saeedniko/LumiCtrl/README.md

# LumiCtrl
Hardware and firmware design for controlling LED strips using an ESP32 microcontroller. Includes circuit design, PCB layout, and software for lighting effects and control.
