saeedniko/LumiCtrl/Hardware/LumiCtrl_rev11/Bottom.pdf

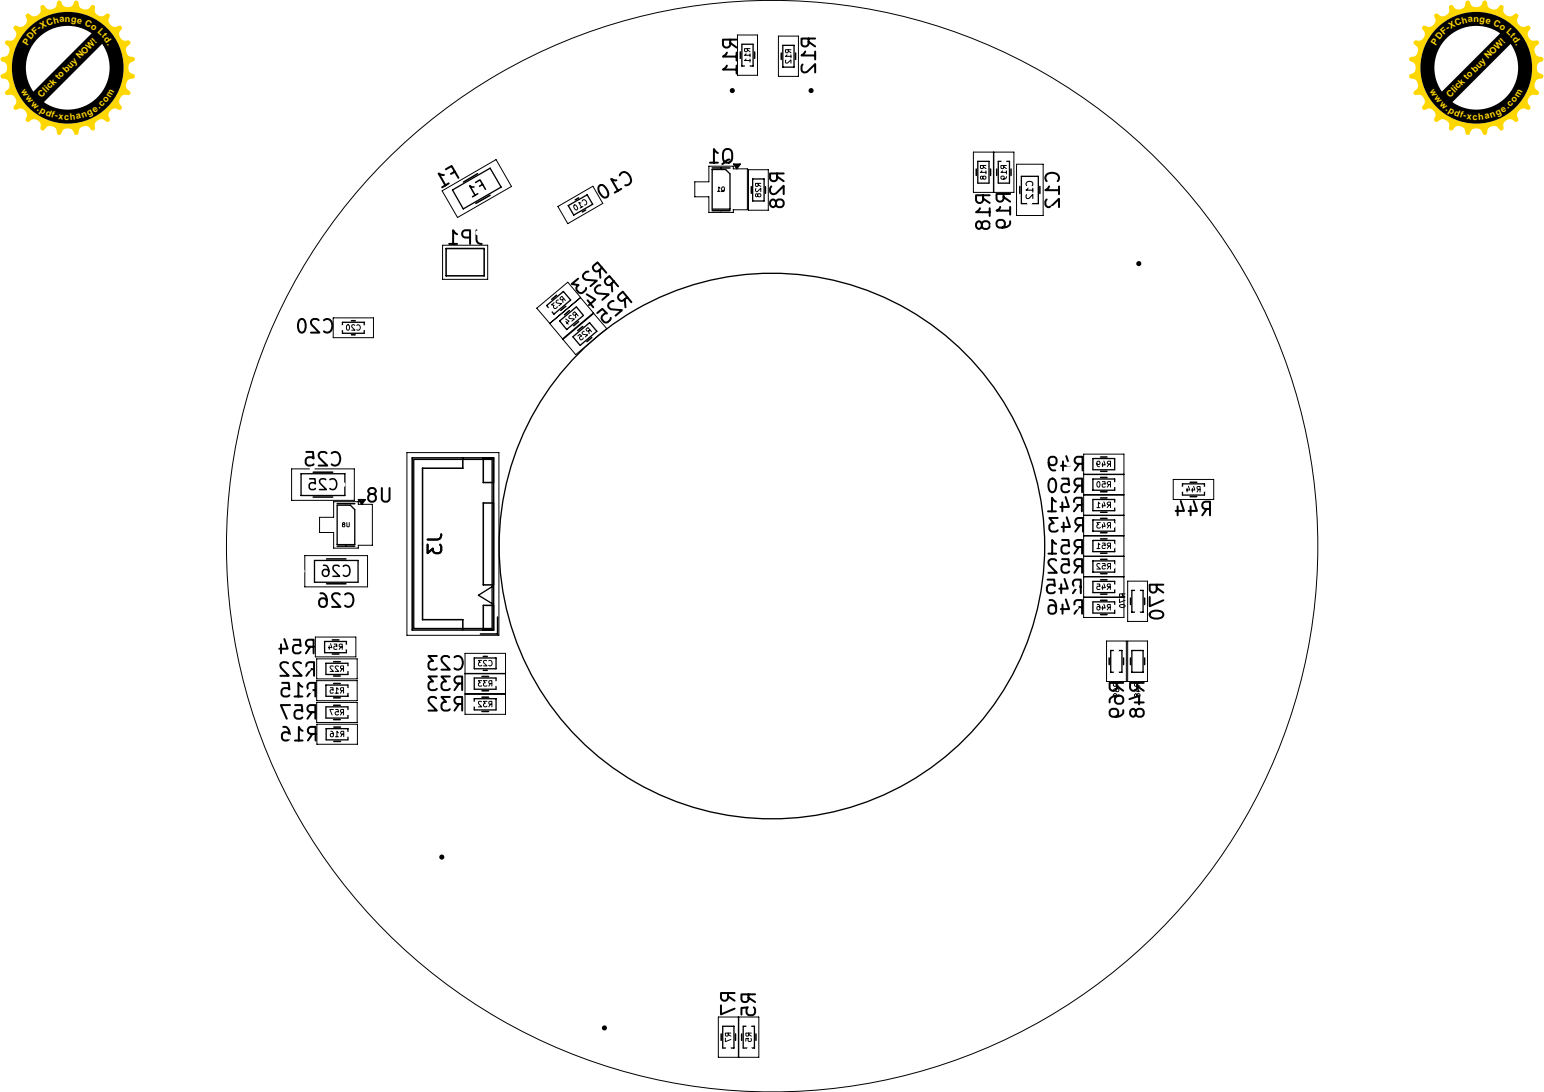
[picture p1: page 1]

PDF-XChange Co Ltd.

Click to buy NOW!

www.pdf-xchange.com

www.pdf-xchange.com (https://www.pdf-xchange.com/buy-now)
