saeedniko/LumiCtrl/Hardware/LumiCtrl_rev11/Schematic.pdf

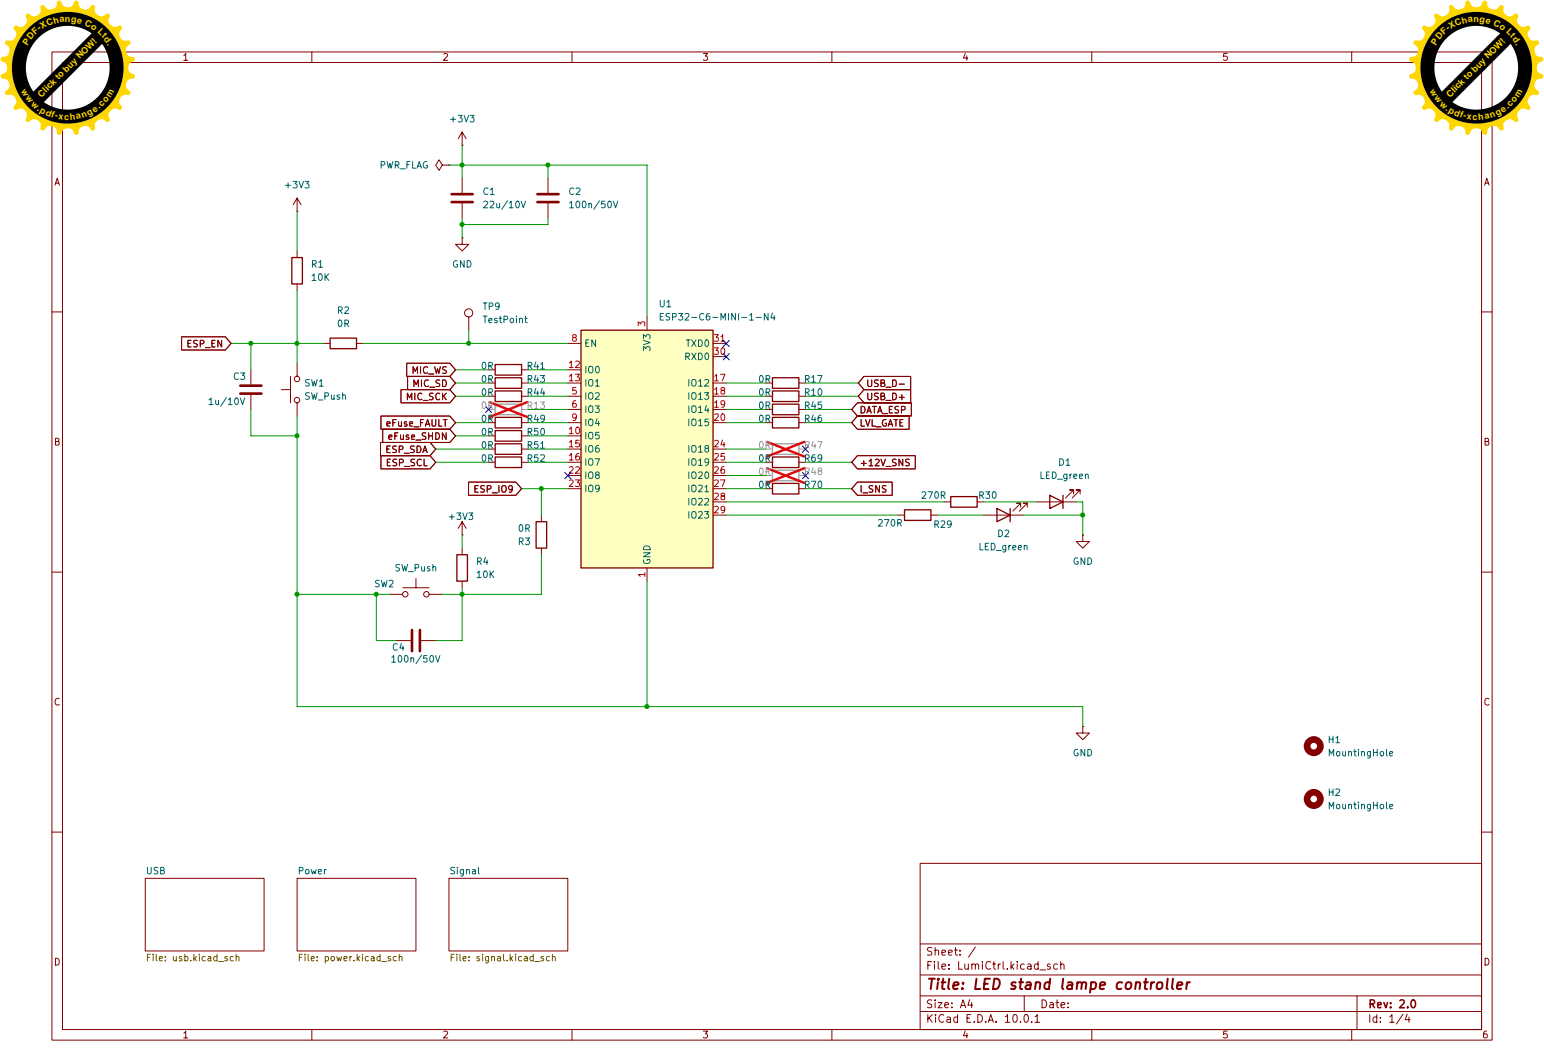
[picture p2: page 1]

PDF-XChange Co Ltd.

Click to buy NOW!

www.pdf-xchange.com

www.pdf-xchange.com (https://www.pdf-xchange.com/buy-now)

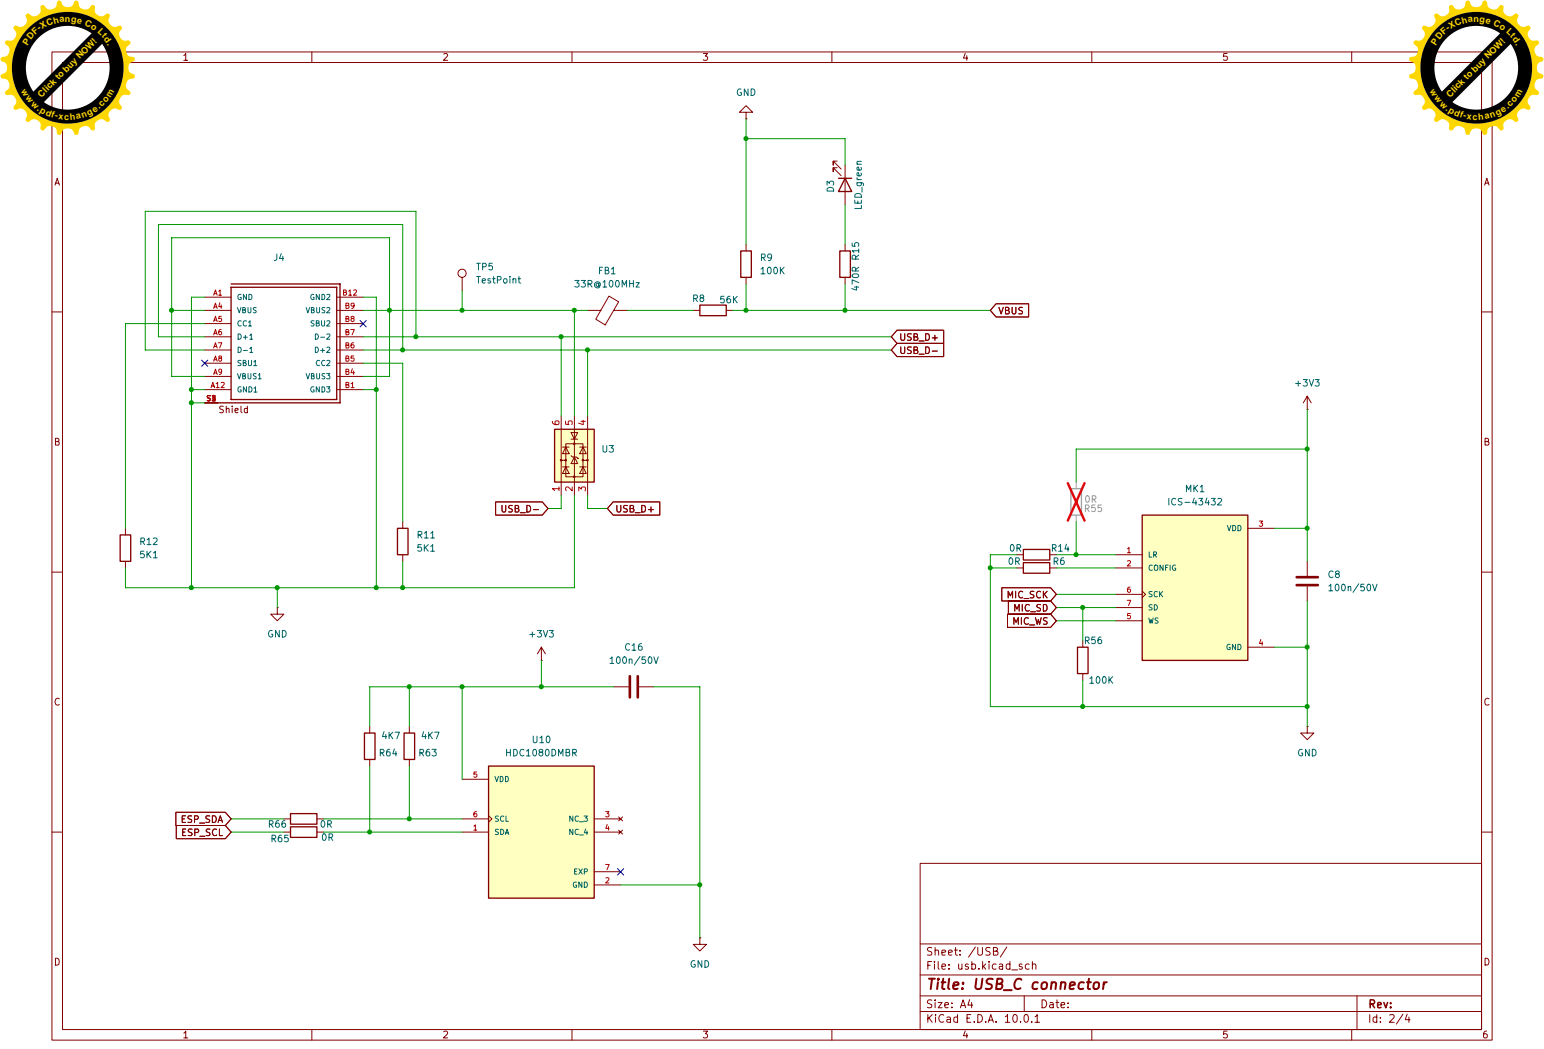
[picture p3: page 2]

Click to buy NOW!

www.pdf-xchange.com

www.pdf-xchange.com (https://www.pdf-xchange.com/buy-now)

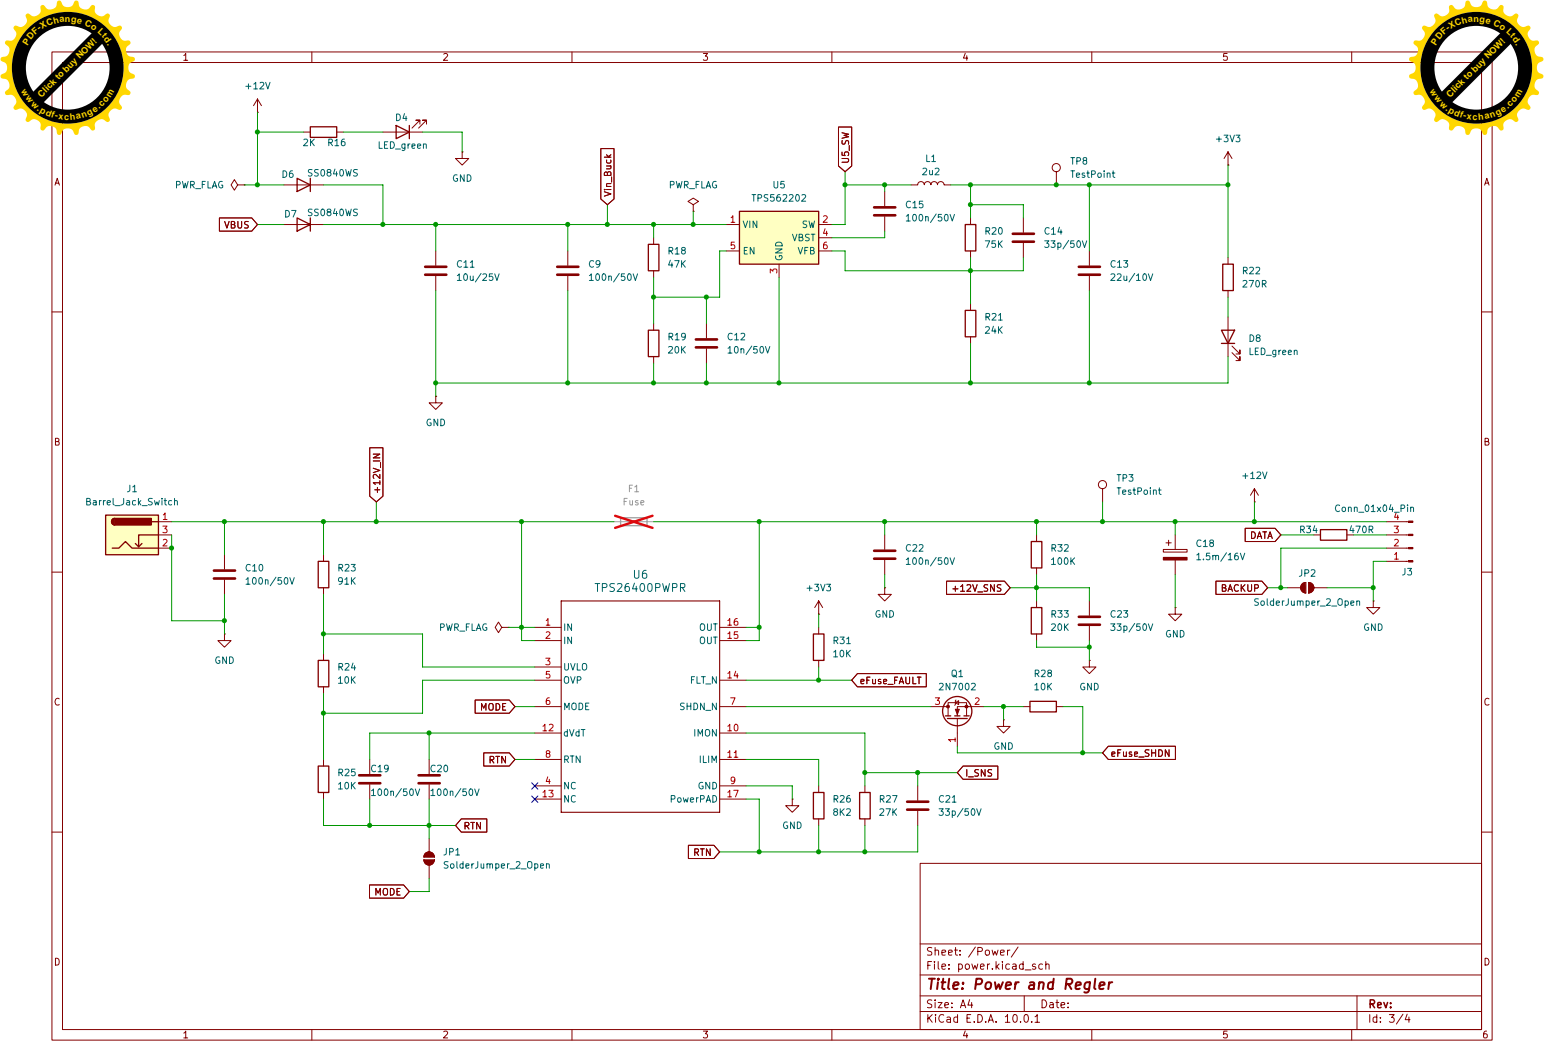
[picture p4: page 3]

Click to buy NOW!

www.pdf-xchange.com

www.pdf-xchange.com (https://www.pdf-xchange.com/buy-now)

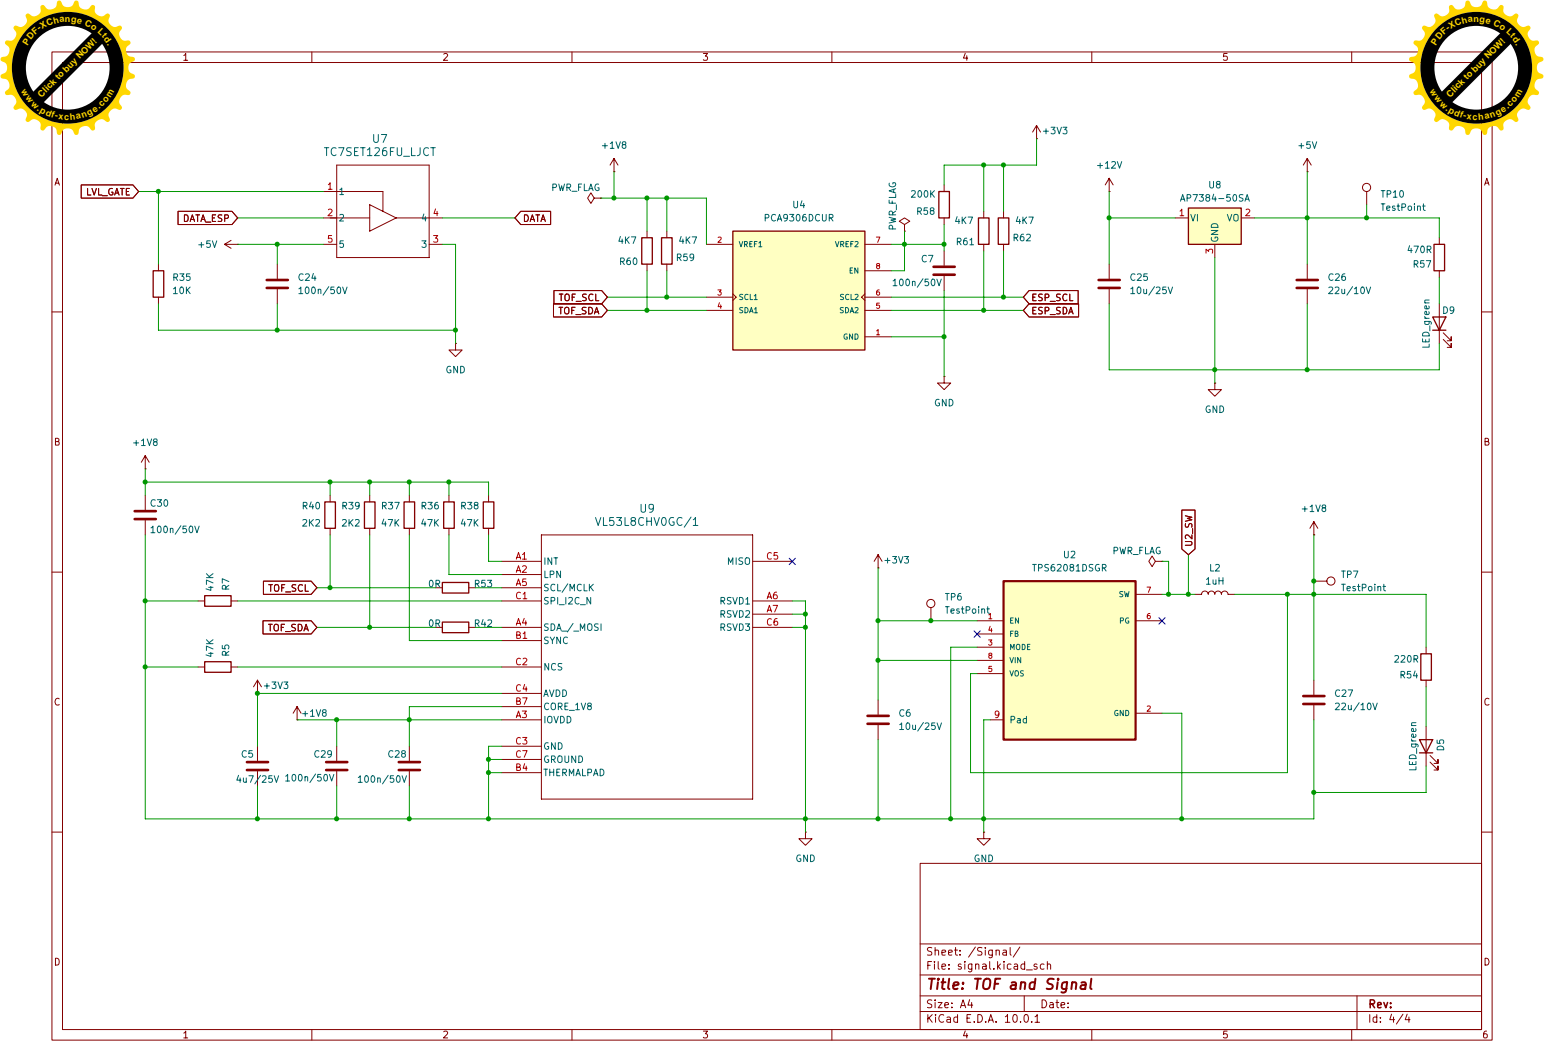
[picture p5: page 4]

Click to buy NOW!

www.pdf-xchange.com

www.pdf-xchange.com (https://www.pdf-xchange.com/buy-now)
