saeedniko/LumiCtrl/Hardware/LumiCtrl_rev10/LumiCtrl.pdf

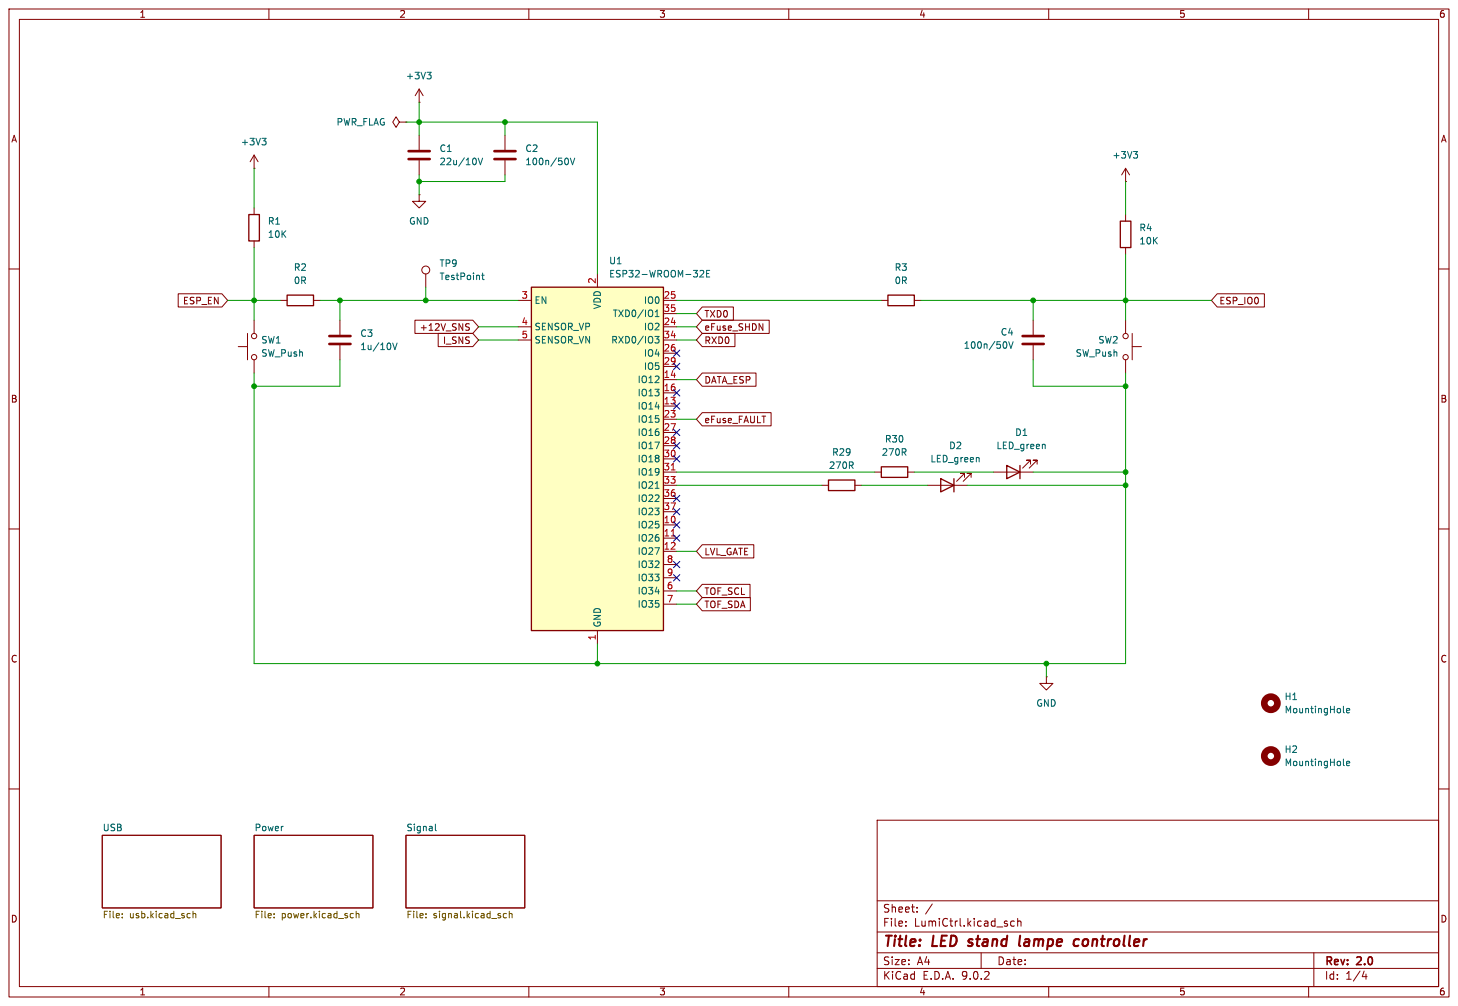
[picture p6: page 1]

Id: 1/4 Title: LED stand lampe controller File: LumiCtrl.kicad_sch Sheet: / Signal File: signal.kicad_sch Power File: power.kicad_sch USB

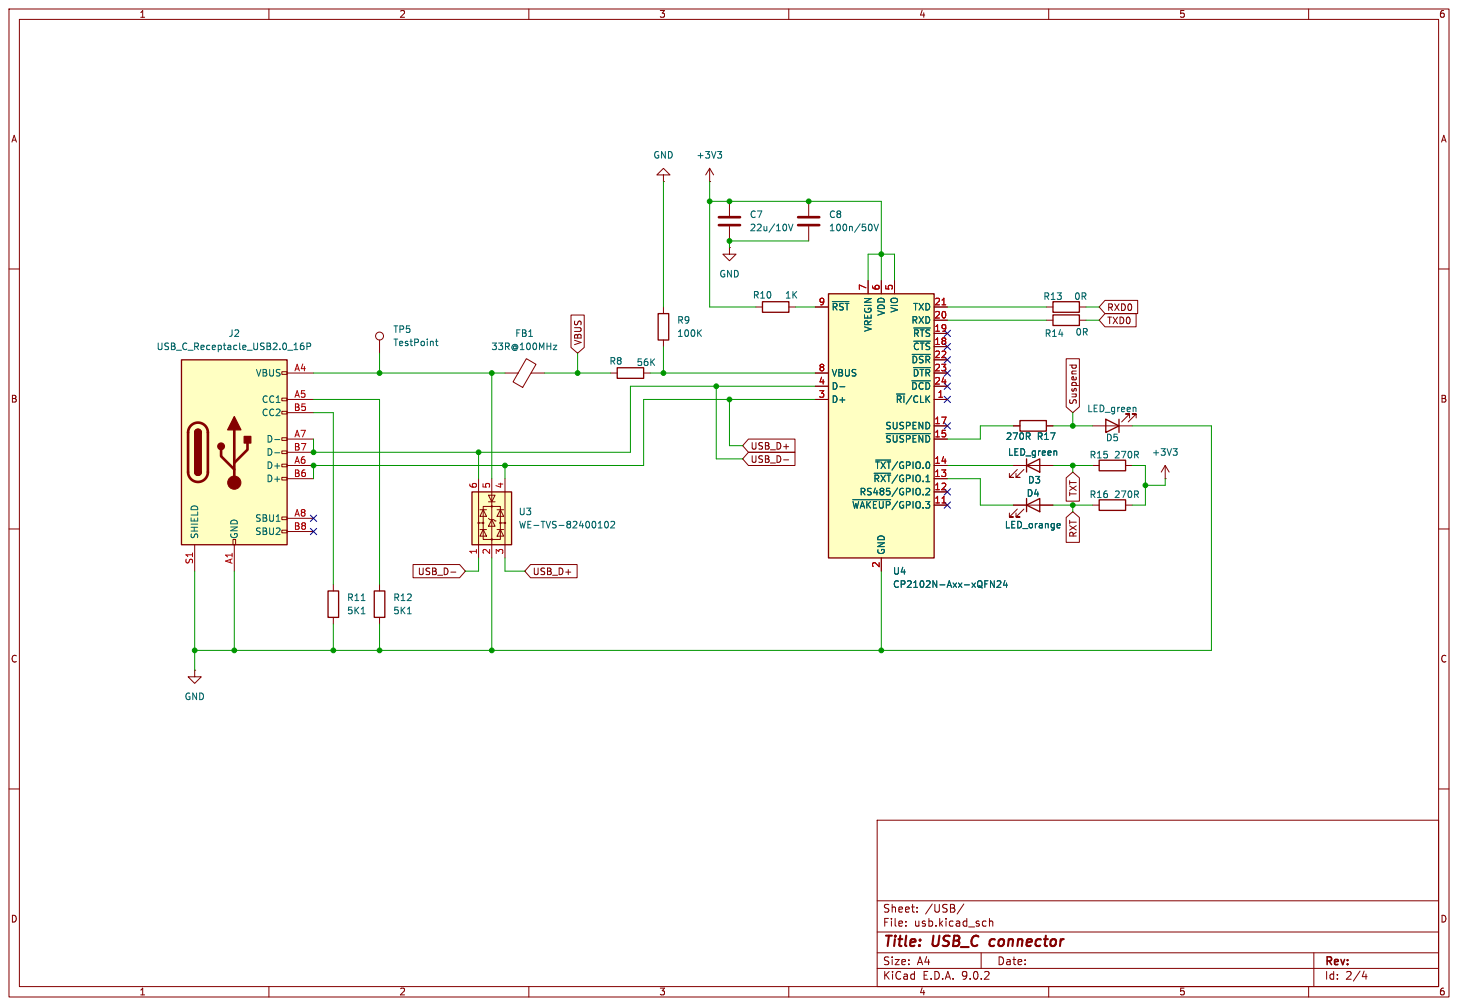
[picture p7: page 2]

5 TXD 21 RXD 20 ~{RTS} 19 ~{CTS} 18 ~{DSR} 22 ~{DTR} 23 ~{DCD} 24 ~{RI}/CLK1 SUSPEND 17 ~{SUSPEND}15 ~{TXT}/GPIO.014 ~{RXT}/GPIO.113 RS485/GPIO.2 12 ~{WAKEUP}/GPIO.311 U4 CP2102N-Axx-xQFN24 R14 0R

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

Id: 2/4 Title: USB_C connector File: usb.kicad_sch Sheet: /USB/

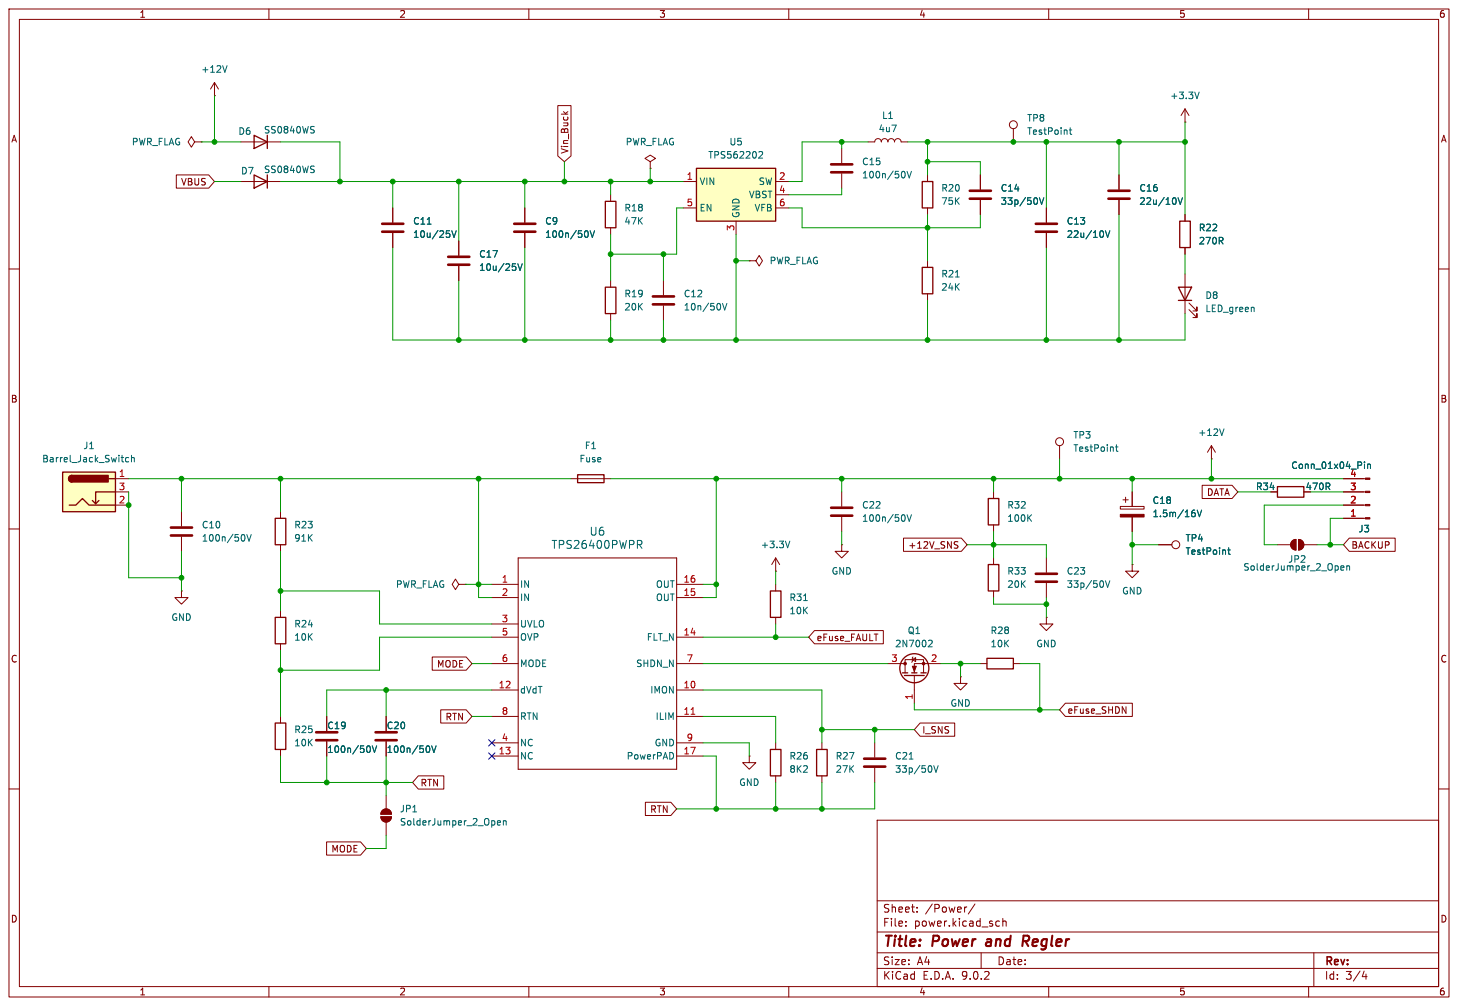
[picture p8: page 3]

Id: 3/4 Title: Power and Regler File: power.kicad_sch Sheet: /Power/

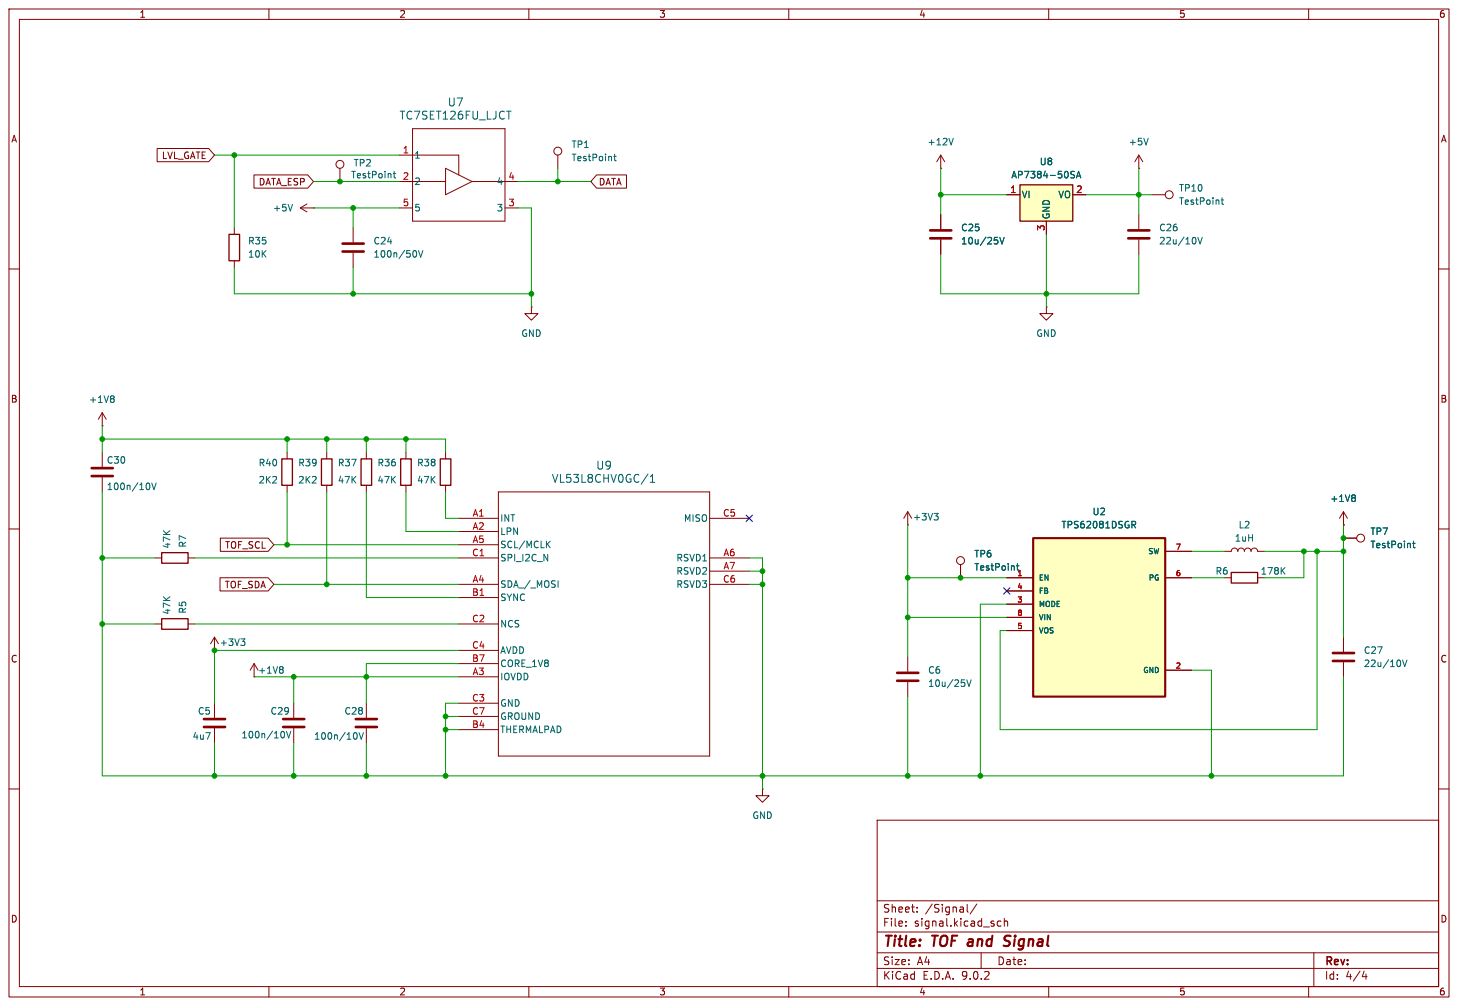
[picture p9: page 4]

Id: 4/4 Title: TOF and Signal File: signal.kicad_sch Sheet: /Signal/ R37
