saeedniko/LumiCtrl/(commit log)

2025-09-01 initialize new project
    [LumiCtrl.kicad_pcb, LumiCtrl.kicad_sch]
2025-09-07 Add usb
    [LumiCtrl.kicad_sch, untitled.kicad_sch]
2025-09-10 Add USB_C buck
    [untitled.kicad_sch]
2025-09-11 Add power
    [LumiCtrl.kicad_sch, power.kicad_sch, usb.kicad_sch]
2025-09-13 Add signal and LDO
    [LumiCtrl.kicad_sch, power.kicad_sch, signal.kicad_sch, usb.kicad_sch]
2025-09-13 Add new TOF sensor
    [LumiCtrl.kicad_sch, power.kicad_sch, signal.kicad_sch, usb.kicad_sch]
2025-09-14 Review schematic
    [LumiCtrl.kicad_sch, power.kicad_sch, signal.kicad_sch, usb.kicad_sch]
2025-09-14 Add new USB_C and start Layout
    [LumiCtrl.kicad_pcb, power.kicad_sch, signal.kicad_sch, usb.kicad_sch]
2025-09-19 FInish PCB and Gerber
    [LumiCtrl-B_Cu.gbl, LumiCtrl-B_Mask.gbs, LumiCtrl-B_Paste.gbp, LumiCtrl-B_Silkscreen.gbo, LumiCtrl-Edge_Cuts.gm1, LumiCtrl-F_Cu.gtl, LumiCtrl-F_Mask.gts, LumiCtrl-F_Paste.gtp]
2025-09-20 Update BOM
    [LumiCtrl.kicad_sch, power.kicad_sch, signal.kicad_sch, usb.kicad_sch]
2026-02-15 Update capacitor voltage rating from 10V to 50V in schematic
    [signal.kicad_sch]
2026-02-16 Start with version 2
    [LumiCtrl-B_Cu.gbl, LumiCtrl-B_Mask.gbs, LumiCtrl-B_Paste.gbp, LumiCtrl-B_Silkscreen.gbo, LumiCtrl-Edge_Cuts.gm1, LumiCtrl-F_Cu.gtl, LumiCtrl-F_Mask.gts, LumiCtrl-F_Paste.gtp]
2026-02-17 remove old files
    [LumiCtrl-B_Cu.gbl, LumiCtrl-B_Mask.gbs, LumiCtrl-B_Paste.gbp, LumiCtrl-B_Silkscreen.gbo, LumiCtrl-Edge_Cuts.gm1, LumiCtrl-F_Cu.gtl, LumiCtrl-F_Mask.gts, LumiCtrl-F_Paste.gtp]
2026-02-19 Add sound sensor
    [LumiCtrl-B_Cu.gbl, LumiCtrl-B_Mask.gbs, LumiCtrl-B_Paste.gbp, LumiCtrl-B_Silkscreen.gbo, LumiCtrl-Edge_Cuts.gm1, LumiCtrl-F_Cu.gtl, LumiCtrl-F_Mask.gts, LumiCtrl-F_Paste.gtp]
2026-02-20 Add all sensors
    [LumiCtrl.kicad_pcb, LumiCtrl.kicad_sch, usb.kicad_sch]
2026-02-20 Create Gerber file
    [LumiCtrl-B_Cu.gbl, LumiCtrl-B_Mask.gbs, LumiCtrl-B_Paste.gbp, LumiCtrl-B_Silkscreen.gbo, LumiCtrl-Edge_Cuts.gm1, LumiCtrl-F_Cu.gtl, LumiCtrl-F_Mask.gts, LumiCtrl-F_Paste.gtp]
2026-02-22 Create Gerber file and POS and BOM with new sensors
    [LumiCtrl-B_Cu.gbl, LumiCtrl-B_Mask.gbs, LumiCtrl-B_Paste.gbp, LumiCtrl-B_Silkscreen.gbo, LumiCtrl-Edge_Cuts.gm1, LumiCtrl-F_Cu.gtl, LumiCtrl-F_Mask.gts, LumiCtrl-F_Paste.gtp]
2026-02-24 Change C12 to 0805 and Gerber
    [LumiCtrl-B_Cu.gbl, LumiCtrl-B_Mask.gbs, LumiCtrl-B_Paste.gbp, LumiCtrl-B_Silkscreen.gbo, LumiCtrl-Edge_Cuts.gm1, LumiCtrl-F_Cu.gtl, LumiCtrl-F_Mask.gts, LumiCtrl-F_Paste.gtp]
2026-03-01 Add Gerber
2026-03-07 Refactor LED control and web server functionality in main.cpp
2026-06-09 Refactor code structure for improved readability and maintainability
    [LumiCtrl-B_Cu.gbl, LumiCtrl-B_Mask.gbs, LumiCtrl-B_Paste.gbp, LumiCtrl-B_Silkscreen.gbo, LumiCtrl-Edge_Cuts.gm1, LumiCtrl-F_Cu.gtl, LumiCtrl-F_Mask.gts, LumiCtrl-F_Paste.gtp]
2026-06-14 Update schematic with USB and pulldown resistor
    [usb.kicad_sch]
2026-06-21 Add initial implementation of ESP32C6 sketch with WiFi, sensors, and web server functionality
